yuhai520521/MyGitWorkspaceTest/FLYCON_soft&hardware/哈工大鞍山采购BOM20180326.xls

Bill of Material for
On 2018/3/26 at 8:43:42
型号 | 封装 | 名称 | 数量 | 单价 | 总价
220uF/16V | 6.3*7.7/H/220u | 贴片铝电解电容 | 10
82536070 | 0603R | 伍尔特压敏电阻 | 5
82380050100 | 82380050100 | 伍尔特ESD排 | 5
SM04B-GHS-TB | GH1.25-4 | 带锁1.25mm连接器 | 8
SM06B-GHS-TB | GH1.25-6 | 带锁1.25mm连接器 | 8
2.54mm贴片双排插针 | IDC14-SMD | 2.54mm贴片双排插针 | 5
FPC0.5-42长度8cm同侧排线 |  | FPC线 | 5
GHR-04V-S线 | 10cm | 4pin1.25mm带锁连接器线双头 | 5
GHR-06V-S线 | 10cm | 6pin1.25mm带锁连接器线双头 | 5
