yuhai520521/MyGitWorkspaceTest/FLYCON_soft&hardware/FlyconforDSP/Project Outputs for FlyconforDSP/采购BOM20180322.xls

型号 | 封装 | 数量 | 名称 | 单价 | 总价
0.1uF | 0603C | 40 | 电容
10K/0.1% | 0603R | 4 | 电阻
10K | 0603R | 14 | 电阻
10uF/6.3V | 3528/B | 2 | 电容
10uF | 0603C | 1 | 电容
120 | 0603R | 1 | 电阻
18.2K/1% | 0603R | 1 | 电阻
1K/0.1% | 0603R | 2 | 电阻
1K | 0603R | 3 | 电阻
2.2uF | 0603C | 2 | 电容
220 | 0603R | 2 | 电阻
24.9K/1% | 0603R | 1 | 电阻
22pF | 0603C | 2 | 电容
2K/0.1% | 0603R | 1 | 电阻
30.1K/1% | 0603R | 1 | 电阻
30M | 5032Y | 1 | 晶振
500 | 0603R | 1 | 电阻
667/0.1% | 0603R | 1 | 电阻
742792625 | 0603-FB | 8 | 磁珠
74HC08D | TSSOP14 | 1 | 芯片
74HC245 | TSSOP20 | 2 | 芯片
74LVC2G240 | VSSOP8-0.5 | 1 | 芯片
82536040 | 0603R | 1 | 压敏电阻
8550 | SOT23-PNP | 1 | 三极管
ANTINA(NC) | IPEX-20279-00E-03 | 1 | 连接器
BLUE | 0603D | 1 | LED3
BUZZER | SMD-Beep(9.6*9.6) | 1 | 蜂鸣器
DS18B20 | TO-92 | 1 | 芯片
GRREN | 0603D | 1 | LED2
HEAD1X42/4-1734592-2 | FPC0.5-42 | 1 | 接插件
IMP811 | IMP811 | 1 | 芯片
MC33901 | SOIC-8 | 1 | 芯片
MICROSD_SPI | microsd | 1 | 芯片
MPXV7002DP | MPXV7002DP | 1 | 芯片
NLSX4373 | UDFN8 | 2 | 芯片
RED | 0603D | 2 | LED1
RESET_Key | KEY(2*4*3.5) | 1 | 复位按键
TMS320F28335 | LQFP-176 | 1 | 芯片
TPS767D301 | TPS767D301 | 1 | 芯片
ubox-M8N | ublox-M8 | 1 | 芯片
YC248/220 | YC248 | 3 | 16脚阻排
FPC0.5-42长度5cm | FPC0.5-42 | 1 | FPC线
220uf电容
GHR-04V-S | GH1.25-4 |  | 1.25MM接插件座
GHR-06V-S | GH1.25-6 |  | 1.25MM接插件座
