yuhai520521/MyGitWorkspaceTest/FLYCON_soft&hardware/FlyconforDSP/Project Outputs for FlyconforDSP/爱斯电子BOM20180125.xls

型号 | 封装 | 名称 | 数量
3V有源蜂鸣器 | 直插引脚间距7.6mm外径12mm | 蜂鸣器 | 5
1nF | 0603C | 瓷片电容 | 5
470uF/16V | 10*10/G/470uF | 铝电解电容 | 5 |  | 体积：10*8
10uF | 0603C | 瓷片电容 | 20
22uF/6.3V | 3528/B | X7R钽电容 | 5 |  | 16V
10uF/6.3V | 3528/B | X7R钽电容 | 5 |  | 16V
82306050029 | 0603R | 伍尔特双向TVS | 8 |  | 待确定
742792625 | 0603-FB | 磁珠 | 150 | 120@100M
HEAD3X13 | 3X13RA90°弯角 | 接插件 | 10 |  | 没有
POWER_5V | 53048-06 | 接插件 | 10 | 必须是莫莱克斯的连接器 | 没有
iSensor | 53048-12 | 接插件 | 10 |  | 没有
IPEX-20279-00E-03 | IPEX-20279-00E-03 | 接插件 | 10 |  | 没有
3*6*2.5 SMD | 3*6*2.5 SMD | 复位开关 | 10
7.5nH/LQP18M | 0603L | 村田电感 | 5
绿色LED | 0603D | 绿色LED | 20
蓝色LED | 0603D | 蓝色LED | 20
0ZCH0150FF2E | 1210 | 自复位保险丝 | 5 | 6v1.5A
8550 | SOT23-PNP | 三极管 | 10
24.9K/1% | 0603R | 电阻 | 10
120 | 0603R | 电阻 | 50
18.2K/1% | 0603R | 电阻 | 5
30.1K/1% | 0603R | 电阻 | 5
2K/0.1% | 0603R | 电阻 | 5
1K/0.1% | 0603R | 电阻 | 10
10K/0.1% | 0603R | 电阻 | 20
667/0.1% | 0603R | 电阻 | 10 |  | 没有
220 | 0603R | 电阻 | 50
YC164/220 | YC164 | 电阻排 | 10 | 必须是国巨的 | 没有
YC248/120 | YC248 | 电阻排 | 10 |  | 没有
YC248/220 | YC248 | 电阻排 | 10 |  | 没有
74HC245DB | SSOP20 | 芯片 | 8
NLSX4373DR2G | SO8 | 芯片 | 8
MC33901SEF | SOIC-8 | 芯片 | 2
AMS1117-3.3V | SOT223 | 芯片 | 5
IMP811TEUS-T | 4-SOT143 | 芯片 | 5
74HC08D | SO14 | 芯片 | 5
74LVC2G240DC | VSSOP-8 | 芯片 | 2
82536040 | 0603R | 伍尔特压敏电阻 | 100 |  | 待确定
30M晶振 | 5032 | 晶振 | 5
CLM-112-02-G-D-A | SMD | SAMTEC接插件 | 5 |  | 没有
NEO-M8N | NEO-M8N | 芯片 | 2 |  | 待确定
10uF/50V | 直插铝电解电容 | 5*11 | 10 |  | 5*7
22uF/25V | 直插铝电解电容 | 5*11 | 5
103 | 电容 | 0603c | 20
22uF/10V | 直插铝电解电容 | 5*11 | 5 |  | 16v 4*7
LED | 三色灯RGB | 3528 | 10 |  | 没有
10R | 电阻 | 0603r | 10
8k | 电阻 | 0603r | 10 |  | 不拿
120R | 电阻 | 0603r | 10
注：黄色为没有的器件
