yuhai520521/MyGitWorkspaceTest/FLYCON_soft&hardware/FlyconforDSP/Project Outputs for FlyconforDSP/哈工大鞍山贴片/贴片BOM20180322.xls

Comment | Footprint | Description | Designator | pins | Quantity
0.1uF | 0603C | 贴片电容 | C1, C2, C3, C4, C5, C6, C7, C8, C9, C10, C11, C12, C13, C14, C15, C16, C17, C18, C19, C20, C21, C22, C27, C28, C29, C30, C31, C32, C33, C34, C35, C36, C37, C38, C39, C40, C42, C45, C46, C47 | 2 | 40
10K/0.1% | 0603R | 贴片电阻 | R23, R24, R25, R28 | 2 | 4
10K | 0603R | 贴片电阻 | R5, R7, R8, R9, R11, R12, R15, R18, R19, R20, R29, R30, R31, R32 | 2 | 14
10uF/6.3V | 3528/B | 贴片电阻 | C43, C44 | 2 | 2
10uF | 0603C | 贴片电容 | C41 | 2 | 1
120 | 0603R | 贴片电阻 | R10 | 2 | 1
18.2K/1% | 0603R | 贴片电阻 | R16 | 2 | 1
1K/0.1% | 0603R | 贴片电阻 | R22, R26 | 2 | 2
1K | 0603R | 贴片电阻 | R2, R4, R6 | 2 | 3
2.2uF | 0603C | 贴片电容 | C23, C24 | 2 | 2
220 | 0603R | 贴片电阻 | R13, R14 | 2 | 2
24.9K/1% | 0603R | 贴片电阻 | R1 | 2 | 1
24pF | 0603C | 贴片电容 | C25, C26 | 2 | 2
2K/0.1% | 0603R | 贴片电阻 | R21 | 2 | 1
30.1K/1% | 0603R | 贴片电阻 | R17 | 2 | 1
30M | 5032Y | 晶振 | Y1 | 2 | 1
300 | 0603R | 贴片电阻 | R3 | 2 | 1
667/0.1% | 0603R | 贴片电阻 | R27 | 2 | 1
742792625 | 0603-FB | 贴片磁珠 | FB1, FB2, FB3, FB4, FB5, FB6, FB7, FB8 | 2 | 8
74HC08D | TSSOP14 | 芯片 | U13 | 14 | 1
74HC245 | TSSOP20 | 芯片 | U3, U4 | 20 | 2
74LVC2G240 | VSSOP8-0.5 | 芯片 | U10 | 8 | 1
82536040 | 0603R | 贴片压敏电阻 | VDR1 | 2 | 1
8550 | SOT23-PNP | 三极管 | Q1 | 3 | 1
ANTINA(NC) | IPEX-20279-00E-03 | 连接器 | JP1 | 3 | 1
BLUE | 0603D | LED3 | LED3 | 2 | 1
BUZZER | SMD-Beep(9.6*9.6) | 蜂鸣器 | B1 | 2 | 1
DS18B20 | TO-92 | 芯片 | U2 | 3 | 1
GRREN | 0603D | LED2 | LED2 | 2 | 1
HEAD1X42/4-1734592-2 | FPC0.5-42 | 接插件 | J1 | 44 | 1
IMP811 | IMP811 | 芯片 | U12 | 4 | 1
MC33901 | SOIC-8 | 芯片 | U8 | 8 | 1
MICROSD_SPI | microsd | SD卡座 | U7 | 13 | 1
NLSX4373 | UDFN8 | 芯片 | U5, U6 | 8 | 2
RED | 0603D | LED1 | LED1, LED4 | 2 | 2
RESET_Key | KEY(2*4*3.5) | 复位按键 | K1 | 4 | 1
TMS320F28335 | LQFP-176 | 芯片 | U1 | 144 | 1
TPS767D301 | TPS767D301 | 芯片 | U11 | 29 | 1
ubox-M8N | ublox-M8 | 芯片 | U9 | 24 | 1
YC248/220 | YC248 | 贴片阻排 | RP1, RP2, RP3 | 16 | 3
注：以上标黄的为辽宁鞍山邮寄
其他元件由深圳邮寄
