yuhai520521/MyGitWorkspaceTest/FLYCON_soft&hardware/哈工大鞍山BOM20180325.xlsx

型号 | 封装 | 数量 | 名称 | 单价 | 总价
74HC08D | TSSOP14 | 2 | 芯片 | 2 | 4
74HC245 | TSSOP20 | 4 | 芯片 | 2 | 8
8550 | SOT23-PNP | 5 | pnp三极管 | 0.2 | 1
BUZZER | SMT-Beep(9.6*9.6) | 4 | 贴片蜂鸣器 | 4 | 16
4-1734592-2 | FPC0.5-42 | 6 | 泰科FPC接插件 | 3 | 18
NLSX4373 | UDFN8 | 4 | 芯片 | 6 | 24
RESET_Key | KEY(2*4*3.5) | 10 | 贴片侧按按键 | 0.3 | 3
TMS320F28335 | LQFP-176 | 2 | 芯片 | 95 | 190
YC248/220 | YC248 | 10 | 16脚阻排 | 0.3 | 3
 |  |  |  |  | 267
