yuhai520521/MyGitWorkspaceTest/FLYCON_soft&hardware/FlyconforDSP/Project Outputs for FlyconforDSP/深圳采购BOM报价20180125.xlsx

型号 | 封装 | 名称 | 数量 | 单价 | 总价 | 备注
470uF/10V | 10*10/G/470uF | 铝电解电容 | 10 | 1 | 10
82306050029 | 0603R | 伍尔特双向TVS | 10 | 1 | 10
HEAD3X13 | 3X13RA90°弯角 | 接插件 | 10 | 1 | 10
53048-06 | 53048-06 | 接插件 | 20 | 0.8 | 16
53048-12 | 53048-12 | 接插件 | 20 | 1.2 | 24
IPEX-20279-00E-03 | IPEX-20279-00E-03 | 天线座 | 10 | 2 | 20
7.5nH/LQP18M | 0603L | 村田电感 | 5 | 0.6 | 3
667/0.1% | 0603R | 电阻 | 10 | 0.1 | 1
YC164/220 | YC164 | 电阻排 | 10 | 0.2 | 2
YC248/120 | YC248 | 电阻排 | 10 | 0.5 | 5
YC248/220 | YC248 | 电阻排 | 10 | 0.5 | 5
NLSX4373DR2G | SO8 | 芯片 | 6 | 7 | 42
MC33901SEF | SOIC-8 | 芯片 | 4 | 10 | 40
74LVC2G240DC | VSSOP-8 | 芯片 | 4 | 3 | 12
82536040 | 0603R | 伍尔特压敏电阻 | 100 | 0.3 | 30
CLM-112-02-G-D-A | SMD | SAMTEC接插件 | 2 | 50 | 100 | 货期3天
NEO-M8N | NEO-M8N | GPS模块 | 2 | 65 | 130
900薄刀头 | 烙铁薄刀头 | 烙铁头 | 1 | 7 | 7
总计 |  |  |  |  | 467
