yuhai520521/MyGitWorkspaceTest/(list of files, cad)

Other CAD files:
FLYCON_soft&hardware/FLYCON-example/Debug/DSP2833x_common/source/SD_SPI_Read.obj
FLYCON_soft&hardware/FLYCON-example/Debug/DSP2833x_headers/source/DSP2833x_GlobalVariableDefs.obj
FLYCON_soft&hardware/FLYCON-example/Debug/DSP2833x_common/source/DSP2833x_usDelay.obj
FLYCON_soft&hardware/FLYCON-example/Debug/DSP2833x_common/source/SD_SPI_Erase.obj
FLYCON_soft&hardware/FLYCON-example/Debug/DSP2833x_common/source/DSP2833x_DBGIER.obj
FLYCON_soft&hardware/FLYCON-example/Debug/DSP2833x_common/source/DSP2833x_PieCtrl.obj
FLYCON_soft&hardware/FLYCON-example/Debug/DSP2833x_common/source/ADIS16488.obj
FLYCON_soft&hardware/FLYCON-example/Debug/DSP2833x_common/source/DSP2833x_ADC_cal.obj
FLYCON_soft&hardware/FLYCON-example/Debug/DSP2833x_common/source/DSP2833x_MemCopy.obj
FLYCON_soft&hardware/FLYCON-example/Debug/DSP2833x_common/source/diskio.obj
FLYCON_soft&hardware/FLYCON-example/Debug/DSP2833x_common/source/DSP2833x_EQep.obj
FLYCON_soft&hardware/FLYCON-example/Debug/DSP2833x_common/source/DSP2833x_CSMPasswords.obj
FLYCON_soft&hardware/FLYCON-example/Debug/DSP2833x_common/source/disk_sd.obj
FLYCON_soft&hardware/FLYCON-example/Debug/DSP2833x_common/source/DSP2833x_SysCtrl.obj
FLYCON_soft&hardware/FLYCON-example/Debug/DSP2833x_common/source/DS18B20_1.obj
FLYCON_soft&hardware/FLYCON-example/Debug/DSP2833x_common/source/GPS.obj
FLYCON_soft&hardware/FLYCON-example/Debug/DSP2833x_common/source/SD_SPI_Write.obj
FLYCON_soft&hardware/FLYCON-example/Debug/DSP2833x_common/source/SD_SPI_Registers.obj
FLYCON_soft&hardware/FLYCON-example/Debug/DSP2833x_common/source/DSP2833x_I2C.obj
FLYCON_soft&hardware/FLYCON-example/Debug/DSP2833x_common/source/DSP2833x_PieVect.obj
FLYCON_soft&hardware/FLYCON-example/Debug/DSP2833x_common/source/DSP2833x_Mcbsp.obj
FLYCON_soft&hardware/FLYCON-example/Debug/DSP2833x_common/source/ff.obj
FLYCON_soft&hardware/FLYCON-example/Debug/DSP2833x_common/source/DSP2833x_EPwm.obj
FLYCON_soft&hardware/FLYCON-example/Debug/DSP2833x_common/source/DSP2833x_ECan.obj
FLYCON_soft&hardware/FLYCON-example/Debug/DSP2833x_common/source/DSP2833x_Sci.obj
FLYCON_soft&hardware/FLYCON-example/Debug/DSP2833x_common/source/DSP2833x_Adc.obj
FLYCON_soft&hardware/FLYCON-example/Debug/DSP2833x_common/source/DSP2833x_CodeStartBranch.obj
FLYCON_soft&hardware/FLYCON-example/Debug/DSP2833x_common/source/DSP2833x_DisInt.obj
FLYCON_soft&hardware/FLYCON-example/Debug/DSP2833x_common/source/SBUS.obj
FLYCON_soft&hardware/FLYCON-example/Debug/DSP2833x_common/source/DSP2833x_Xintf.obj
FLYCON_soft&hardware/FLYCON-example/Debug/DSP2833x_common/source/DSP2833x_DefaultIsr.obj
FLYCON_soft&hardware/FLYCON-example/Debug/DSP2833x_common/source/DSP2833x_ECap.obj
FLYCON_soft&hardware/FLYCON-example/Debug/DSP2833x_common/source/SD_SPI_Initialization.obj
FLYCON_soft&hardware/FLYCON-example/Debug/DSP2833x_common/source/DSP2833x_CpuTimers.obj
FLYCON_soft&hardware/FLYCON-example/Debug/DSP2833x_common/source/DSP2833x_Gpio.obj
FLYCON_soft&hardware/FLYCON-example/Debug/DSP2833x_common/source/DSP2833x_DMA.obj
FLYCON_soft&hardware/FLYCON-example/Debug/DSP2833x_common/source/DSP2833x_Spi.obj
