yuhai520521/MyGitWorkspaceTest/FLYCON_soft&hardware/FlyconforDSP/PCB2.0.PDF

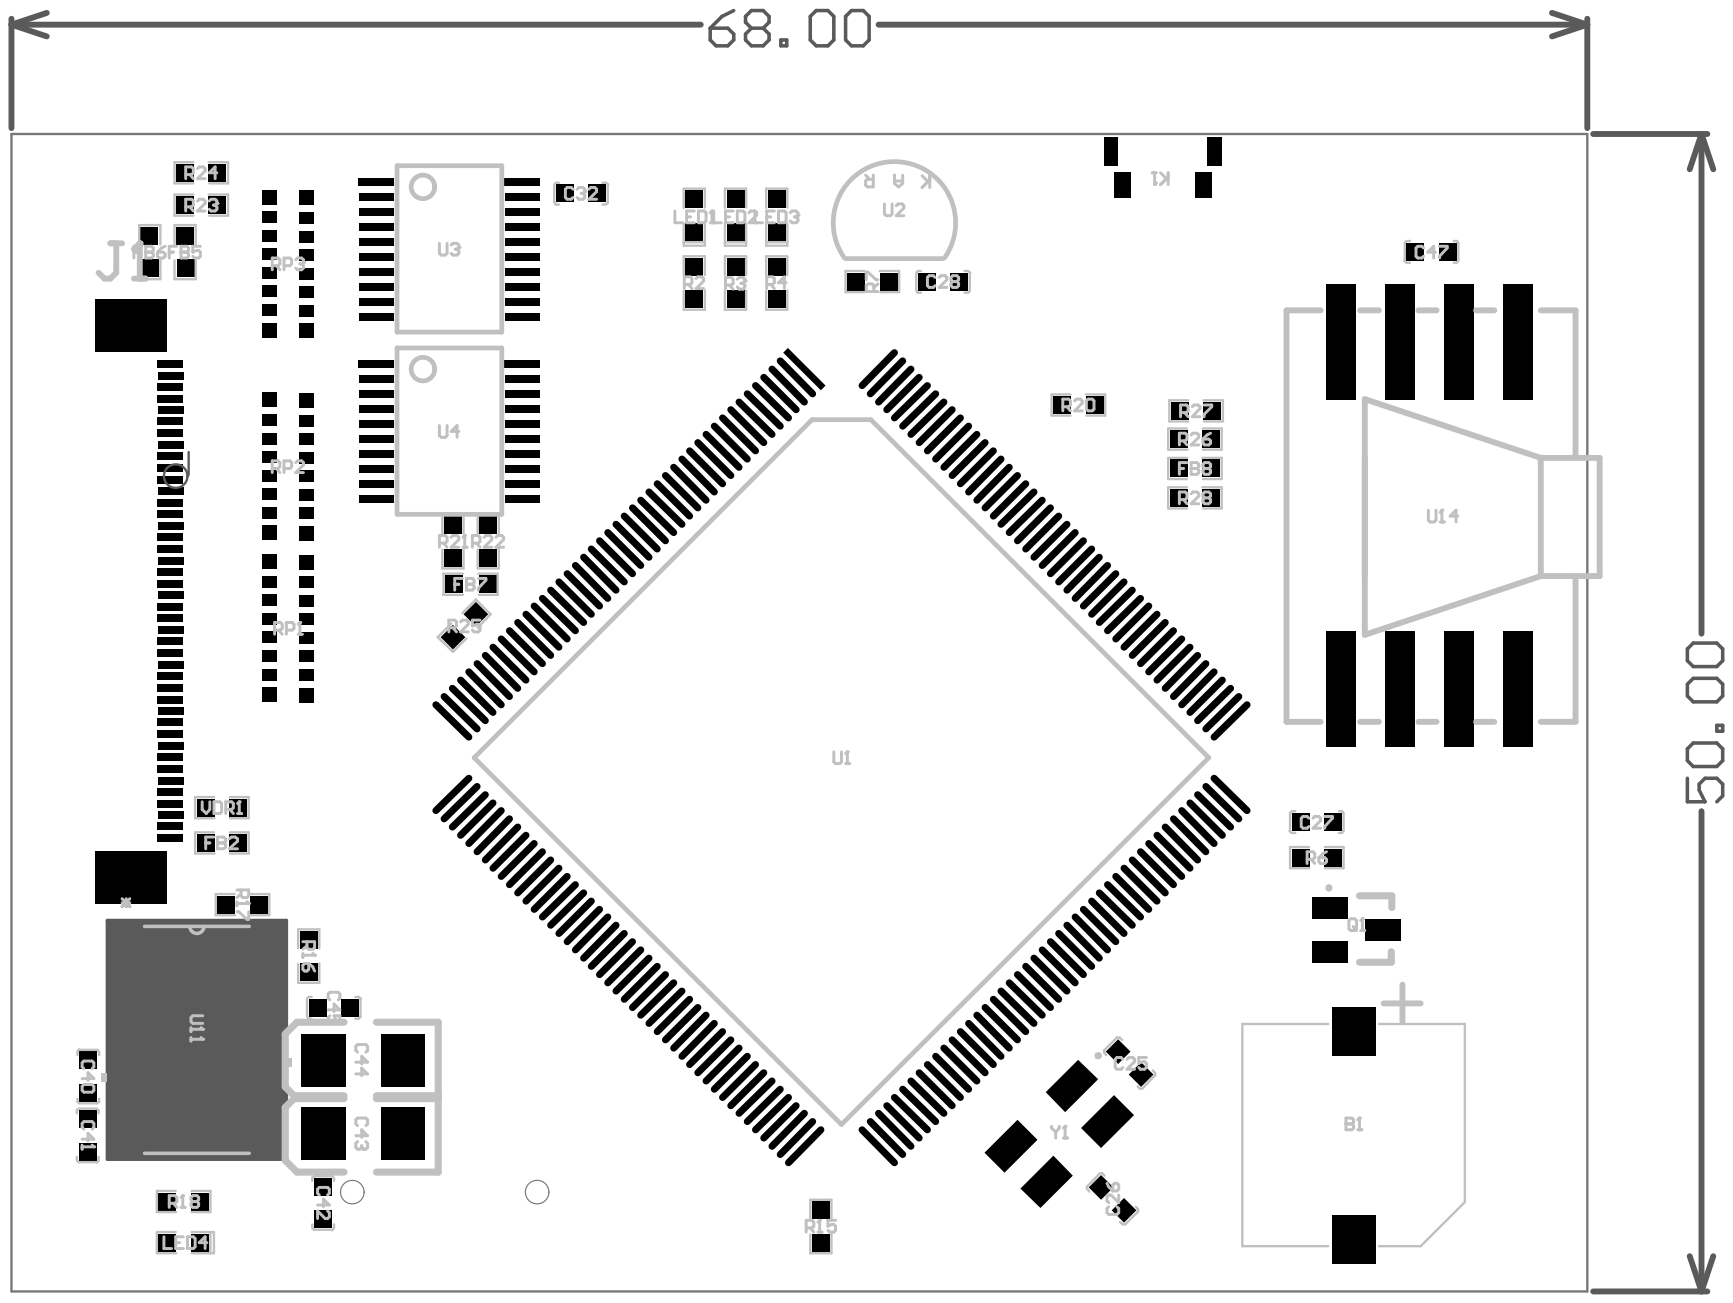
[picture p24: page 1]
