yuhai520521/MyGitWorkspaceTest/FLYCON_soft&hardware/FlyconforDSP/Project Outputs for FlyconforDSP/哈工大鞍山贴片/底层位号图.PDF

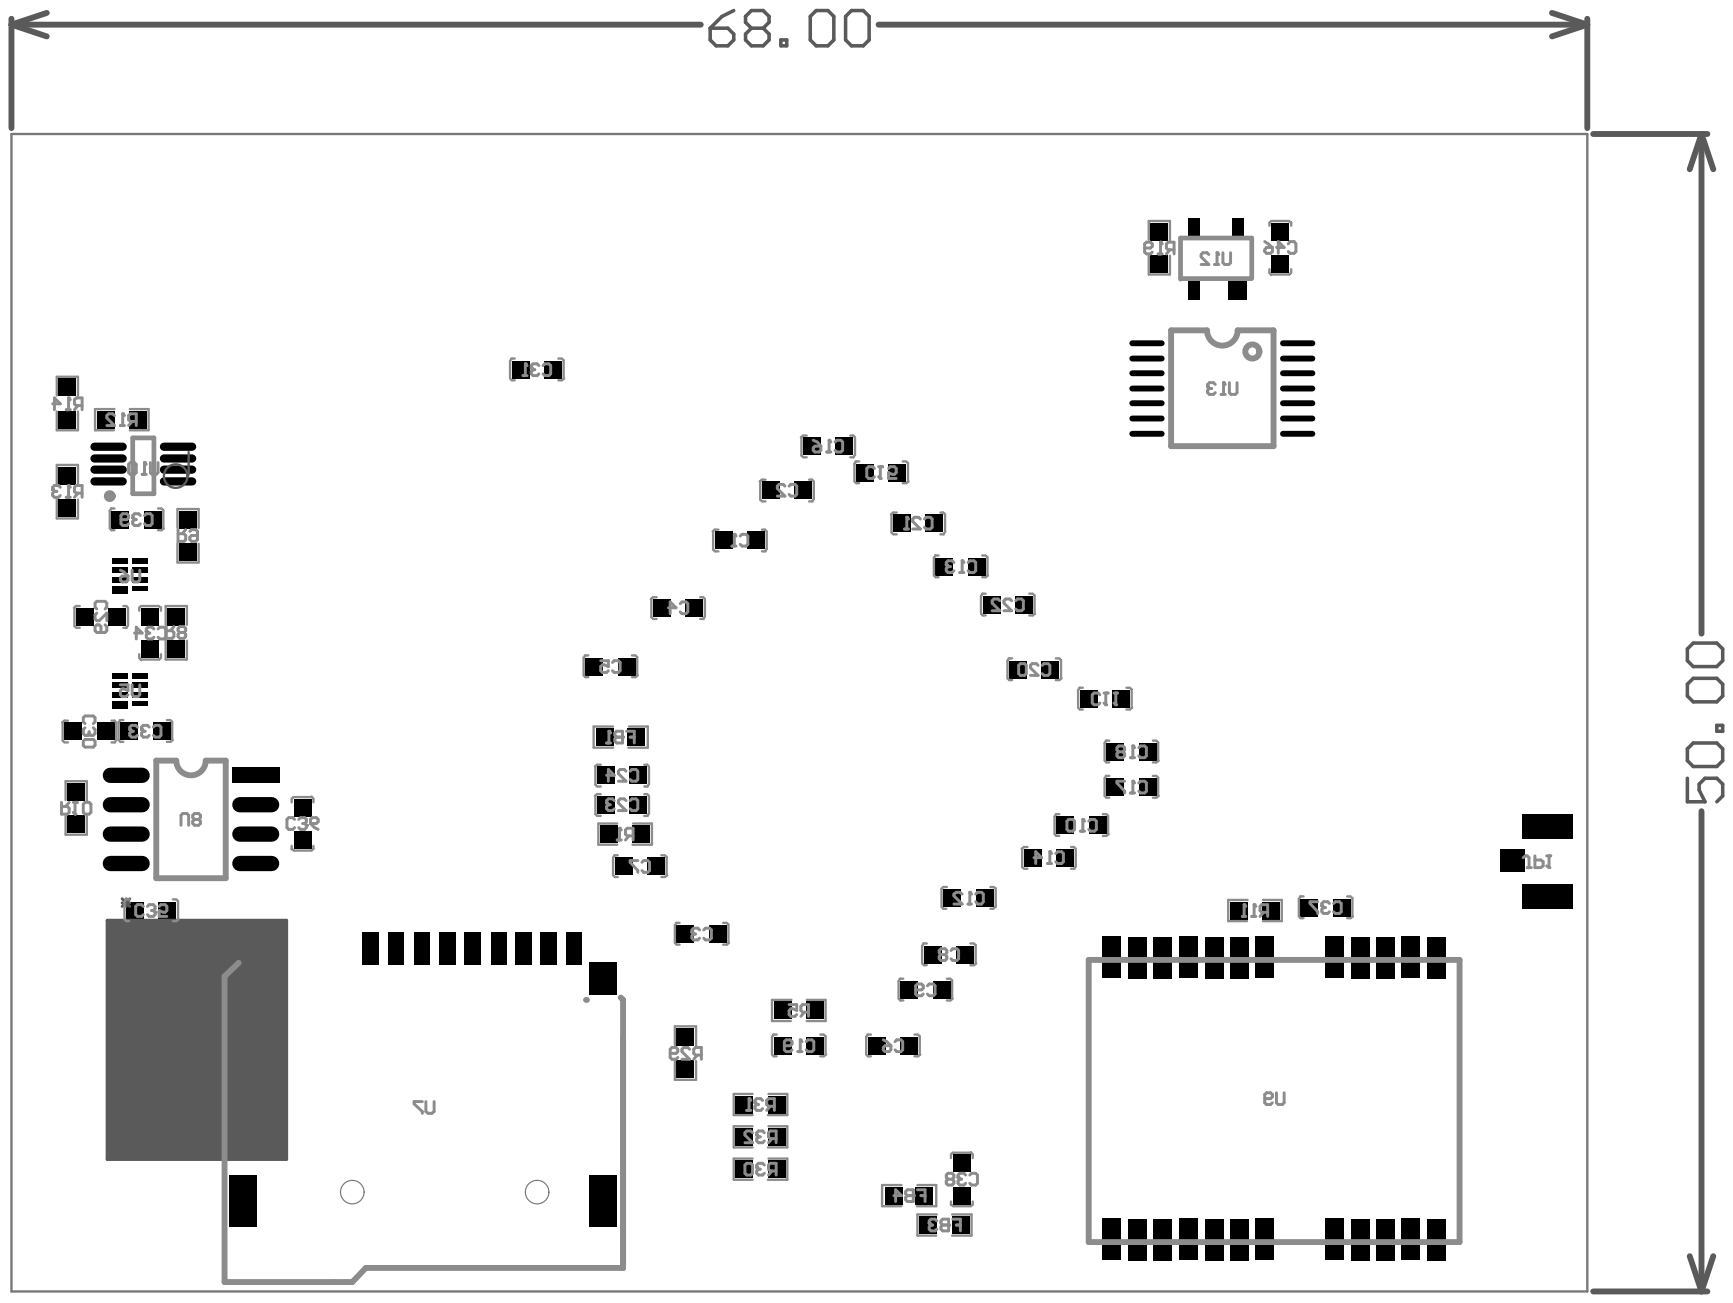
[picture p25: page 1]
