yuhai520521/MyGitWorkspaceTest/(list of files, drawings)

Other design files:
FLYCON_soft&hardware/FlyconforDSP/AD.SchDoc
FLYCON_soft&hardware/FlyconforDSP/F28335.SchDoc
FLYCON_soft&hardware/FlyconforDSP/FlyconforDSP.PrjPcb
FLYCON_soft&hardware/FlyconforDSP/GPS.SchDoc
FLYCON_soft&hardware/FlyconforDSP/IO.SchDoc
FLYCON_soft&hardware/FlyconforDSP/iSensor.PcbDoc
FLYCON_soft&hardware/FlyconforDSP/PCB1.PcbDoc
FLYCON_soft&hardware/FlyconforDSP/PCB2.0.PcbDoc
FLYCON_soft&hardware/FlyconforDSP/PCB.PcbDoc
FLYCON_soft&hardware/FlyconforDSP/POWER.SchDoc
FLYCON_soft&hardware/FlyconforDSP/PWM&CAN&SD.SchDoc
FLYCON_soft&hardware/FlyconforDSP/SBUS&JTAG.SchDoc
FLYCON_soft&hardware/FlyconforDSP/SBUS.SchDoc
FLYCON_soft&hardware/FlyconforDSP/UART&SBUS&JTAG.SchDoc
FLYCON_soft&hardware/IOBoardPCB/IO.SchDoc
FLYCON_soft&hardware/IOBoardPCB/IOBoard.PrjPcb
FLYCON_soft&hardware/IOBoardPCB/PCB1.PcbDoc
FLYCON_soft&hardware/iSensorPCB/PCB_Project/iSensor.PcbDoc
FLYCON_soft&hardware/iSensorPCB/PCB_Project/iSensor.PrjPcb
FLYCON_soft&hardware/iSensorPCB/PCB_Project/iSensor.SchDoc
FLYCON_soft&hardware/iSensorPCB/PCB_Project/PCB1.PcbDoc
FLYCON_soft&hardware/iSensorPCB/PCB_Project/PCB2.PcbDoc
PCBLib/研发中心PCB库文件.PcbLib
PCBLib/研发中心原理图库文件.SchLib
