yuhai520521/MyGitWorkspaceTest/FLYCON_soft&hardware/FLYCON-example/DSP2833x_common/include/stdbool.h

//
// stdbool.h
//
//      Copyright (c) Microsoft Corporation. All rights reserved.
//
// The C Standard Library <stdbool.h> header.
//
#ifndef _STDBOOL
#define _STDBOOL

#define __bool_true_false_are_defined   1

#ifndef __cplusplus

#define bool    _Bool
#define false   0
#define true    1

#endif /* __cplusplus */

#endif /* _STDBOOL */

/*
 * Copyright (c) 1992-2010 by P.J. Plauger.  ALL RIGHTS RESERVED.
 * Consult your license regarding permissions and restrictions.
V5.30:0009 */
