yuhai520521/MyGitWorkspaceTest/(commit log)

2018-03-06 16405配置OK
    [ADIS16488.obj, DS18B20_1.obj, DSP2833x_ADC_cal.obj, DSP2833x_Adc.obj, DSP2833x_CSMPasswords.obj, DSP2833x_CodeStartBranch.obj, DSP2833x_CpuTimers.obj, DSP2833x_DBGIER.obj]
2018-03-06 GIT软件使用说明修改
2018-03-06 飞控硬软件上传
    [AD.SchDoc, F28335.SchDoc, FlyconforDSP.PrjPcb, GPS.SchDoc, IO.SchDoc, PCB.PcbDoc, POWER.SchDoc, PWM&CAN&SD.SchDoc]
2018-03-07 ADC调试
2018-03-07 ADC调试1
2018-03-13 sBUS解析
2018-03-22 飞控板2.0
    [AD.SchDoc, ADIS16488.obj, DS18B20_1.obj, DSP2833x_ADC_cal.obj, DSP2833x_Adc.obj, DSP2833x_CSMPasswords.obj, DSP2833x_CodeStartBranch.obj, DSP2833x_CpuTimers.obj]
2018-03-23 飞控板2.0&IO&isensor
    [F28335.SchDoc, FlyconforDSP.PrjPcb, PCB2.0.PcbDoc, TOTAL-BOM.xlsx, iSensor.PrjPcb, iSensor.SchDoc, 研发中心PCB库文件.PcbLib]
2018-03-29 pwm以及isensor
    [ADIS16488.obj, DS18B20_1.obj, DSP2833x_ADC_cal.obj, DSP2833x_Adc.obj, DSP2833x_CSMPasswords.obj, DSP2833x_CodeStartBranch.obj, DSP2833x_CpuTimers.obj, DSP2833x_DBGIER.obj]
2018-04-23 SD卡卡驱动
    [ADIS16488.obj, DS18B20_1.obj, DSP2833x_ADC_cal.obj, DSP2833x_Adc.obj, DSP2833x_CSMPasswords.obj, DSP2833x_CodeStartBranch.obj, DSP2833x_CpuTimers.obj, DSP2833x_DBGIER.obj]
2018-07-10 IIC驱动
    [SD_SPI_Transmission.obj]
